mmahjoub5/tayloe-sdr/README.md

# tayloe-sdr
Custom Hardware &amp; SDR with ownership of entire stack

# credits
https://github.com/darius3241/Software-Defined-Radio
