mmahjoub5/tayloe-sdr/code/websdr/sdr/DOCKER.md

# WebSDR on the Pi with Docker

One image (`Dockerfile`), four services (`docker-compose.yml`: bridge, engine, ft8, server). No registry.

## Build on the Pi (from `code/` on the Mac)

The sources are a few MB; the Pi downloads GNU Radio itself (the first build takes a while, later ones reuse
the apt layer).

    COPYFILE_DISABLE=1 tar --exclude __pycache__ --exclude '*.egg-info' --exclude websdr/sdr/build \
        -cf - radiolib gnu-radio/iq_bridge.py websdr/sdr \
      | ssh pi@10.0.0.216 'rm -rf ~/websdr-src && mkdir ~/websdr-src && tar -xf - -C ~/websdr-src \
          && cp ~/websdr-src/websdr/sdr/docker-compose.yml ~/websdr/'
    ssh pi@10.0.0.216 'cd ~/websdr-src && docker build -f websdr/sdr/Dockerfile -t websdr:latest .'

Or build on the Mac (arm64 too, so no emulation) and copy the image; this needs several GB free on the Mac:

    docker buildx build --platform linux/arm64 -f websdr/sdr/Dockerfile -t websdr:latest --load .
    docker save websdr:latest | gzip | ssh pi@10.0.0.216 'gunzip | docker load'

## First time on the Pi

    sudo apt install docker.io docker-compose        # Docker 26, Compose 2.26 on trixie
    sudo usermod -aG docker pi                       # log out and back in
    sudo systemctl disable --now rp2040-rtltcp      # only one program can open the board
    mkdir -p ~/websdr && echo "SDR_KEY=memagic" > ~/websdr/.env

OpenWebRX keeps the RTL dongle; its "Tayloe board" device stops working while this runs.

## Run

    cd ~/websdr && docker compose up -d             # http://10.0.0.216:8090/#key=memagic
    docker compose logs -f engine                   # or bridge, server
    docker compose down

The code isn't baked into the image: compose mounts `~/websdr-src` (bridge script, `websdr/sdr/`) and the engine
compiles `engine.grc` when it starts (~10 s). So a code change is the `tar | ssh` copy above, then
`docker compose up -d --force-recreate engine ft8 server` (and `bridge` if `iq_bridge.py` changed); no `docker build`.
Rebuild the image only when packages, radiolib or the pinned ft8_lib commit change. Services restart on their own after a crash or a reboot.

Each engine start sends the board to 1.17 MHz for about 15 s: `grcc` creates the Board Tuner with its default
parameters while compiling, and those go out to the bridge until the running engine's tuner corrects them. The bridge exits if the board is unplugged and restarts until it's back;
the engine's Board Tuner repeats its frequency every 3 s, so the board comes back tuned.

Public access: point cloudflared at `http://localhost:8090`.
