mmahjoub5/tayloe-sdr/code/notes/am_fft.png

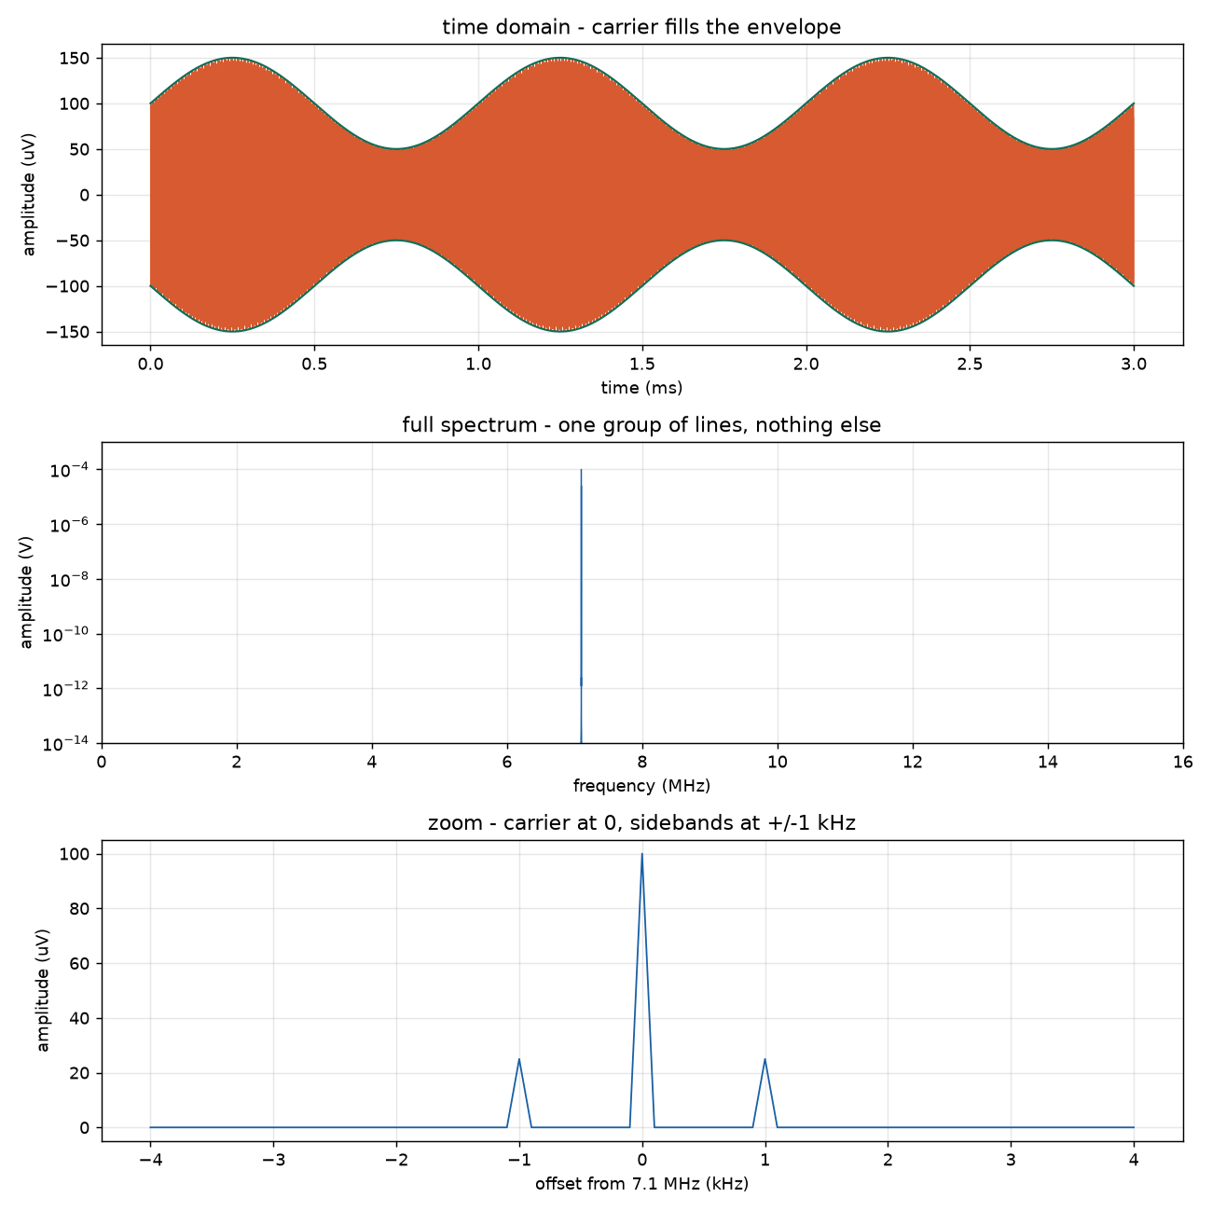
code/notes/am_fft.png
