mmahjoub5/tayloe-sdr/code/notes/am_textbook_style.png

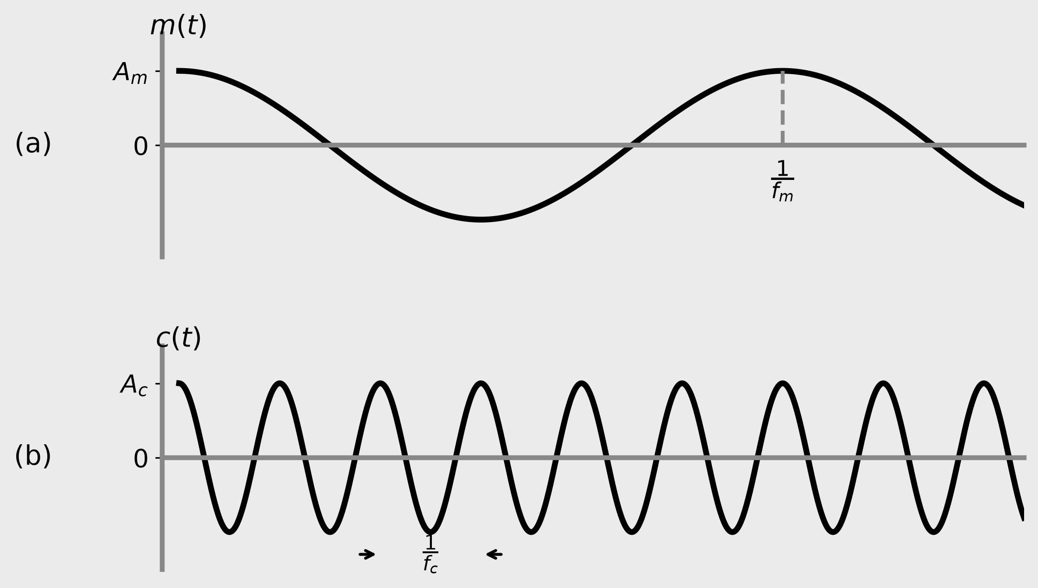
code/notes/am_textbook_style.png
