mmahjoub5/tayloe-sdr/meche/out/enclosure.FCStd

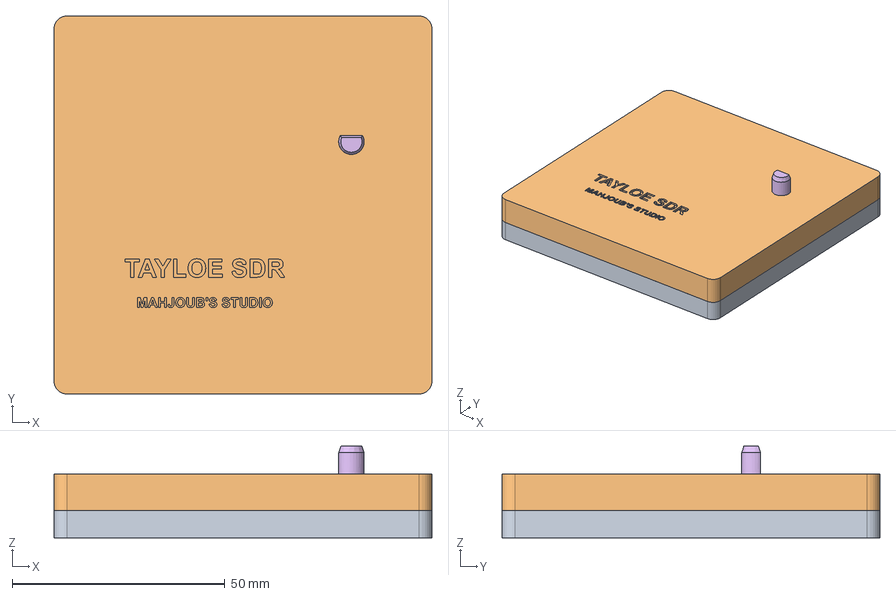
[picture p4: CAD file, 2026-10-29]
meche/out/enclosure.FCStd
88.8 x 88.8 x 21.5 mm
R_0402_1005Metric
C_0603_1608Metric
R_0402_1005Metric002
R_0402_1005Metric004
TSSOP-16_4.4x5mm_P0.65mm
C_0603_1608Metric002
C_0402_1005Metric
C_0603_1608Metric004
MSOP-8_3x3mm_P0.65mm
TSSOP-14_4.4x5mm_P0.65mm
R_0402_1005Metric006
C_0603_1608Metric006
R_0402_1005Metric008
R_0402_1005Metric010
R_0402_1005Metric012
L_0805_2012Metric
C_0402_1005Metric002
C_0603_1608Metric008
R_0402_1005Metric014
L_0603_1608Metric
R_0402_1005Metric016
SMA_Samtec_SMA-J-P-H-ST-EM1_EdgeMount
R_0402_1005Metric018
C_0603_1608Metric010
C_0805_2012Metric
C_0805_2012Metric002
L_0805_2012Metric002
MSOP-10_3x3mm_P0.5mm
C_0805_2012Metric004
R_0402_1005Metric020
C_0603_1608Metric012
R_0402_1005Metric022
R_0402_1005Metric024
C_0402_1005Metric004
C_0201_0603Metric
C_0402_1005Metric006
C_0603_1608Metric014
R_0402_1005Metric026
C_0603_1608Metric016
R_0402_1005Metric028
R_0402_1005Metric030
R_0402_1005Metric032
R_0402_1005Metric034
R_0402_1005Metric036
C_0603_1608Metric018
C_0603_1608Metric020
R_0402_1005Metric038
R_0402_1005Metric040
C_0201_0603Metric002
C_0402_1005Metric008
R_0402_1005Metric042
R_0402_1005Metric044
R_0402_1005Metric046
C_0402_1005Metric010
R_0402_1005Metric048
R_0402_1005Metric050
R_0402_1005Metric052
C_0805_2012Metric006
Crystal_SMD_3225-4Pin_3.2x2.5mm
R_0402_1005Metric054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
