mmahjoub5/tayloe-sdr/meche/out/print/lid.step

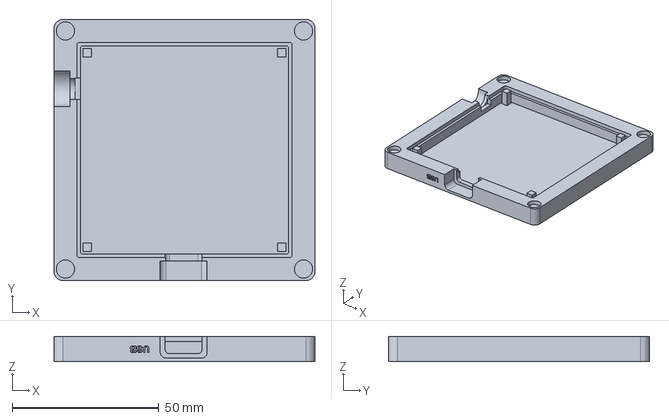
[picture p5: CAD file, 2026-10-29]
meche/out/print/lid.step
88.8 x 88.8 x 8.58 mm
