mmahjoub5/tayloe-sdr/meche/out/enclosure_base.step

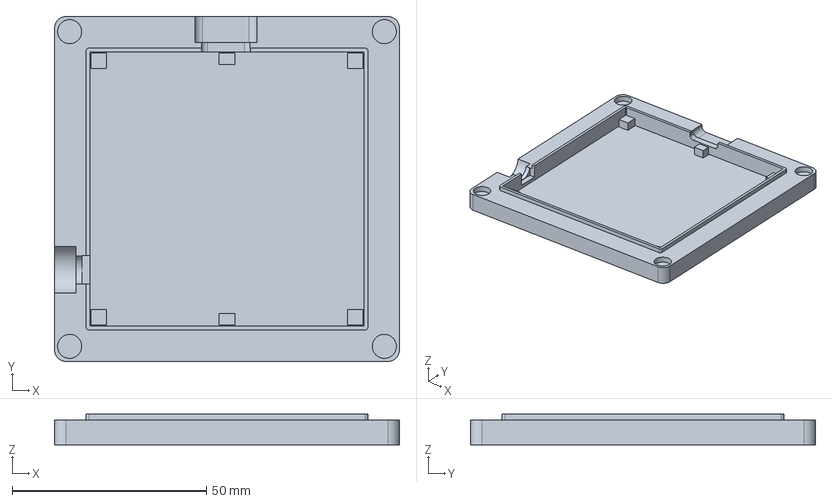
[picture p6: CAD file, 2026-10-29]
meche/out/enclosure_base.step
88.8 x 88.8 x 7.92 mm
