mmahjoub5/tayloe-sdr/(list of files, cad)

Other CAD files:
meche/radio.FCStd
meche/out/print/base.step
meche/out/enclosure_lid.step
meche/out/enclosure_base.stl
meche/out/enclosure_lid.stl
meche/out/print/base.3mf
meche/out/print/base.stl
meche/out/print/lid.3mf
meche/out/print/lid.stl
