mmahjoub5/tayloe-sdr/LTspice files/Mixer and amp model.asc

B2: bv; V={rf_amp}*(1+{mod_index}*sin(2*pi*{mod_freq}*time))*sin(2*pi*{RF_freq}*time)
C1: Cap; {sample_cap}
C2: Cap; {sample_cap}
C3: Cap; {sample_cap}
C4: Cap; {sample_cap}
C5: Cap; 100p
C6: Cap; 100p
C8: Cap; 100n
L1: ind; 560n
R1: Res; 1k
R2: Res; 1k
R3: Res; 31.6k
R4: res; 31.6k
R5: Res; 1k
R6: Res; 1k
R7: Res; 31.6k
R8: Res; 1k
R9: res; 31.6k
R14: Res; 50
S1: sw; MYSW
S2: sw; MYSW
S3: sw; MYSW
S4: sw; MYSW
U1: OPAx320-Q1
U2: OPAx320-Q1
V1: voltage; 1.65
V2: Voltage; 3.3
V7: voltage; PULSE(0 5 0 1n 1n {SW_time} {4*SW_time})
V8: voltage; PULSE(0 5 {SW_time} 1n 1n {SW_time} {4*SW_time})
V9: voltage; PULSE(0 5 {2*SW_time} 1n 1n {SW_time} {4*SW_time})
V10: voltage; PULSE(0 5 {3*SW_time} 1n 1n {SW_time} {4*SW_time})
Named nets: 0, V_0_deg, V_90_deg, V_180_deg, V_270_deg, 00, 11, 01, 10, V+, V-, I, Q, +3V3_ANALOG
.inc LM4562Fixed.LIB
.model MYSW SW(Vt=0.9 Vh=0 Ron=4 Roff=100G)
.tran 0 3m 500u 2n
;.ac dec 100 100k 100Meg
;.noise V(V_outQ) V3 dec 10 10 100meg
;.op
.param LO_freq={RF_freq} LO_period={1/LO_freq} SW_time={LO_period/4}
Signals for voltage-controlled switches 
used to simulate our multiplexer.
Multiplexer
Simulation Control
;step oct param Audio_freq 1000 10000 1
.param Audio_freq 0
RF signal in
BandPass Filter
.include OPAx320-Q1.lib
.param RF_freq = 7.100Meg
.param mod_freq = 1k
.param mod_index = 0.5
.param rf_amp = 100u
.meas tran idc AVG V(I) FROM 0.8m TO 1.2m
V={rf_amp}*(1+{mod_index}*sin(2*pi*{mod_freq}*time))*sin(2*pi*{RF_freq}*time)
.param sample_cap 100n
.options plotwinsize=0 numdgt=7 reltol=1e-5 vntol=1e-9 abstol=1e-13 trtol=1
AM Signal
DSB Signal
V={rf_amp}*sin(2*pi*{RF_freq}*time)*sin(2*pi*{mod_freq}*time)
.param mod_amp 1
SSB Signal
V={rf_amp}*sin(2*pi*({RF_freq}+{mod_freq})*time)
