mmahjoub5/tayloe-sdr/radio-project/radio-project.kicad_pcb

## KiCad design radio-project/radio-project.kicad_pcb (2026-10-29)

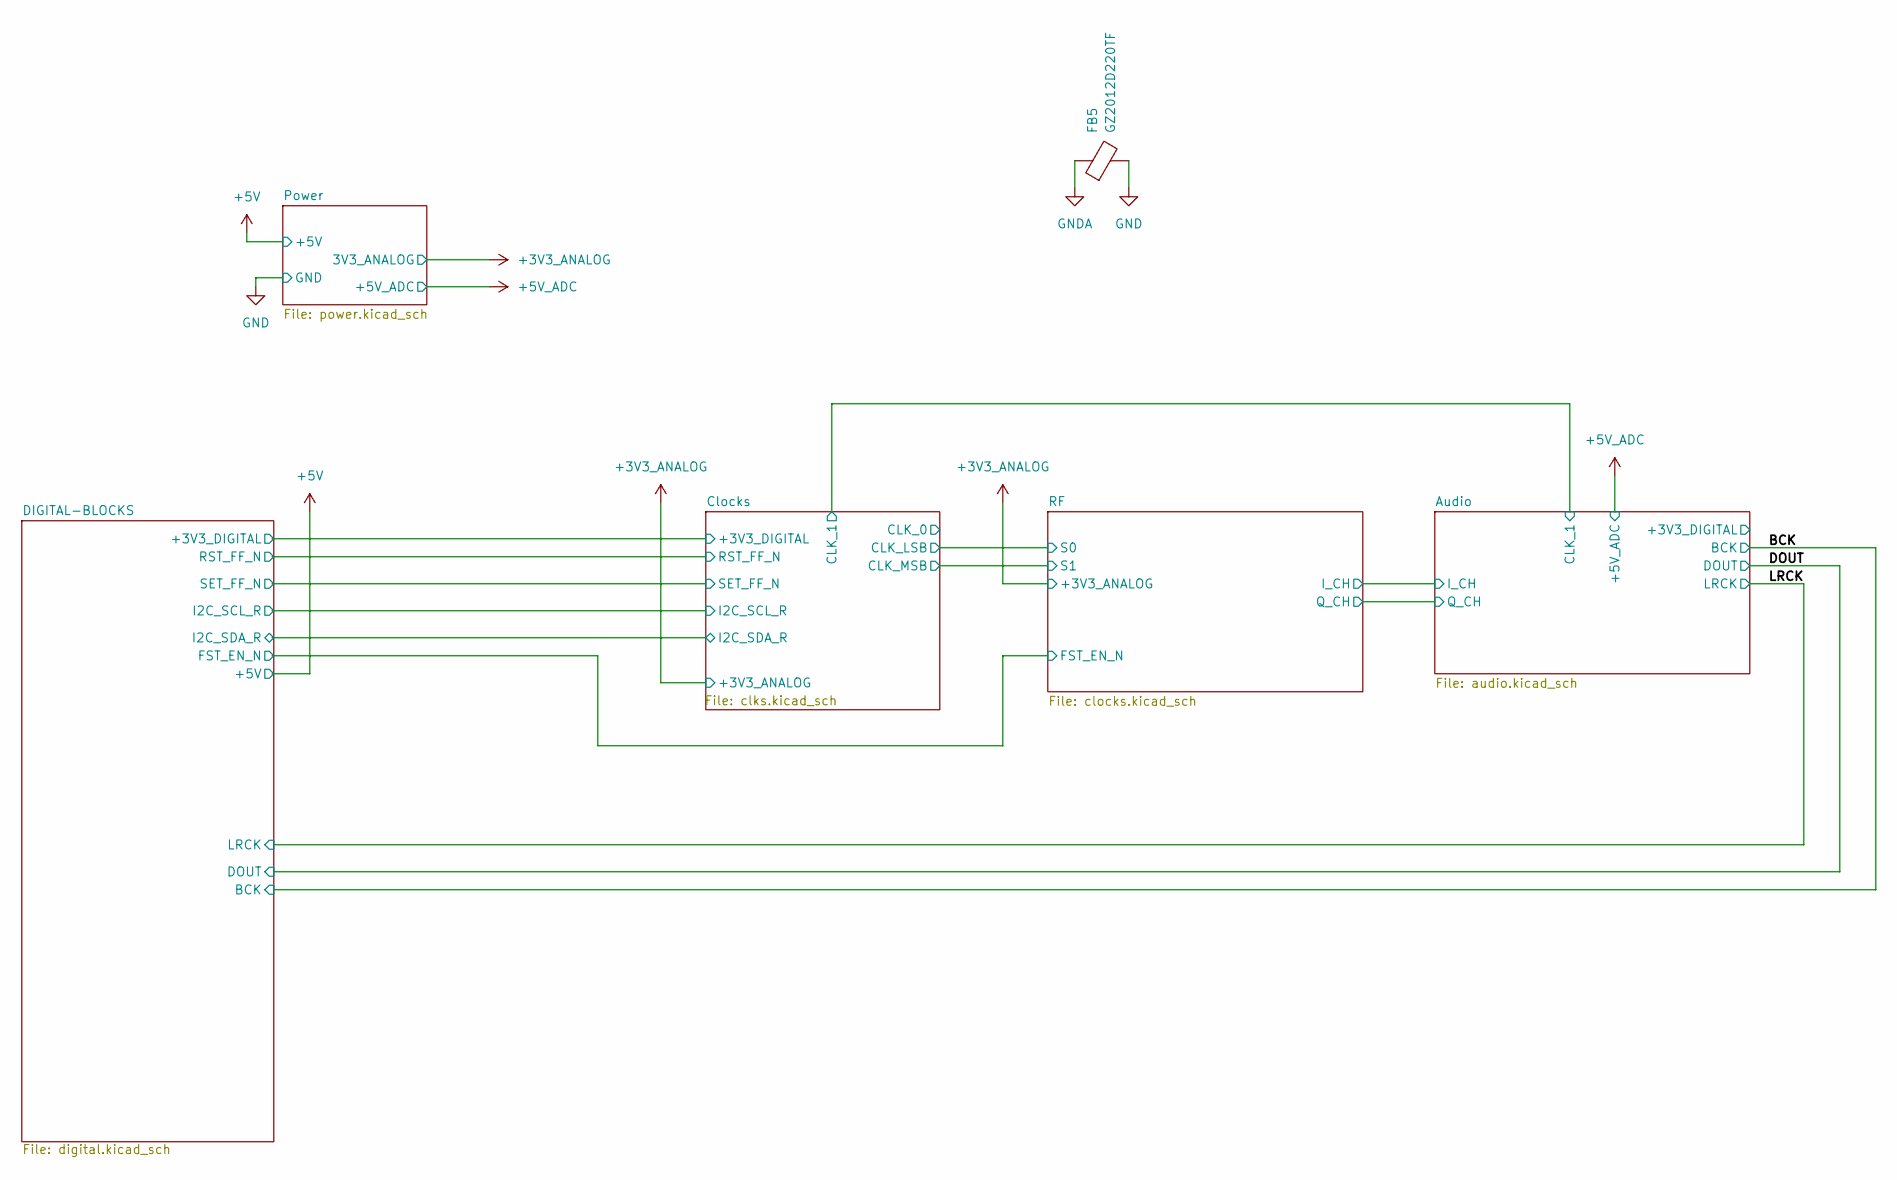
[picture p13: schematic radio-project.kicad_sch]

Parts:
FB5: GZ2012D220TF; L_0805_2012Metric

Connections:
GND: FB5.2; also elsewhere on the board
GNDA: FB5.1; also elsewhere on the board

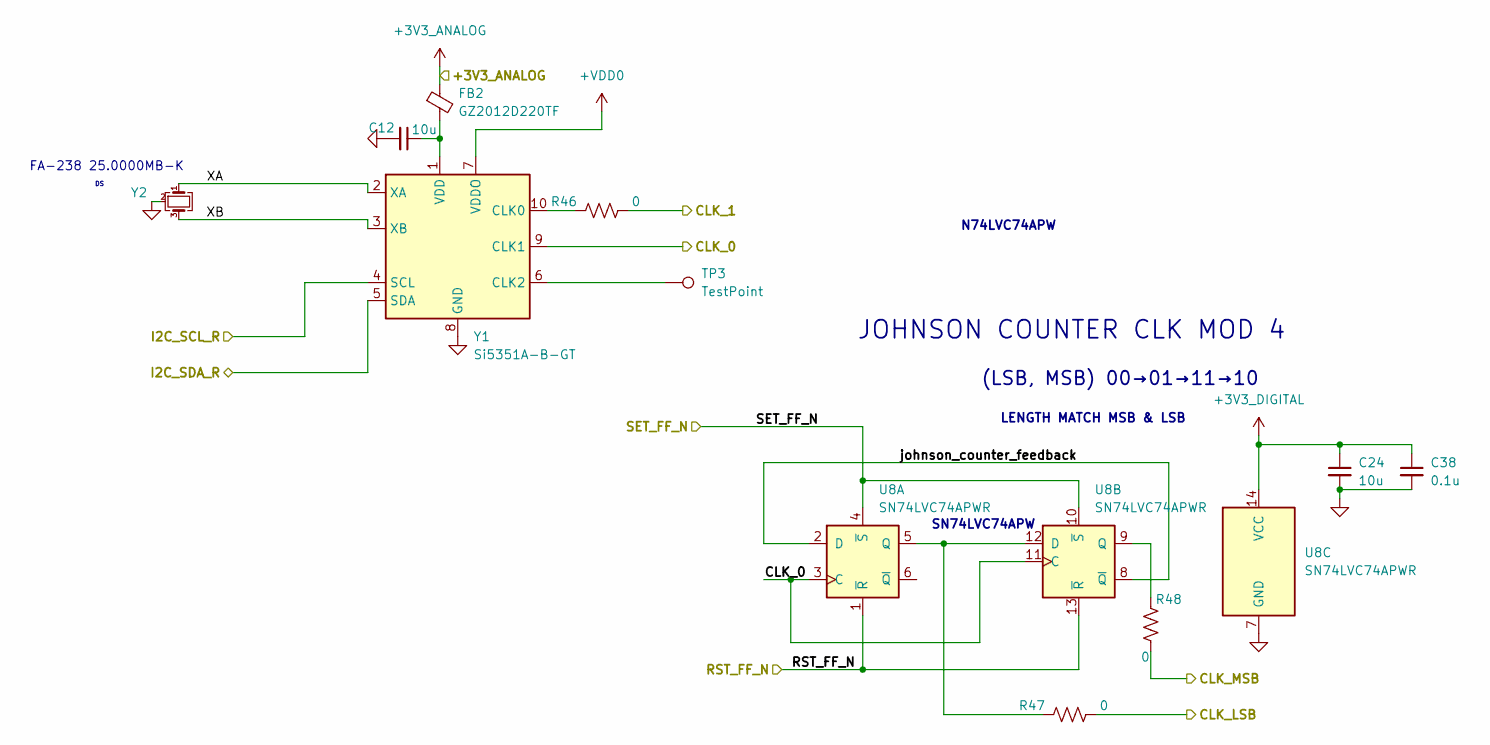
[picture p14: schematic clks.kicad_sch]

Parts:
C12, C24: 10u; C_0603_1608Metric
C38: 0.1u; C_0201_0603Metric
FB2: GZ2012D220TF; L_0805_2012Metric
R46, R47, R48: 0; R_0402_1005Metric
TP3: TestPoint; TestPoint_Pad_D1.0mm
U8: SN74LVC74APWR; TSSOP-14_4.4x5mm_P0.65mm
Y1: Si5351A-B-GT; MSOP-10_3x3mm_P0.5mm
Y2: 25Mhz; Crystal_SMD_3225-4Pin_3.2x2.5mm

Connections:
+3V3_ANALOG: FB2.1; also elsewhere on the board
+3V3_DIGITAL: C24.1, C38.1, U8.14 (VCC); also elsewhere on the board
+VDD0: Y1.7 (VDDO)
/Audio/CLK_1: R46.2; also elsewhere on the board
/Clocks/CLK_0: U8.3 (C), U8.11 (C), Y1.9 (CLK1)
/Clocks/CLK_LSB: R47.2; also elsewhere on the board
/Clocks/CLK_MSB: R48.2; also elsewhere on the board
/Clocks/I2C_SCL_R: Y1.4 (SCL); also elsewhere on the board
/Clocks/I2C_SDA_R: Y1.5 (SDA); also elsewhere on the board
/Clocks/RST_FF_N: U8.1 (~R), U8.13 (~R); also elsewhere on the board
/Clocks/SET_FF_N: U8.4 (~S), U8.10 (~S); also elsewhere on the board
/Clocks/XA: Y1.2 (XA), Y2.1
/Clocks/XB: Y1.3 (XB), Y2.3
/Clocks/johnson_counter_feedback: U8.2 (D), U8.8 (~Q)
GND: C12.2, C24.2, C38.2, U8.7 (GND), Y1.8 (GND), Y2.2 (G), Y2.4 (G); also elsewhere on the board
unnamed: R47.1, U8.5 (Q), U8.12 (D)
unnamed: R48.1, U8.9 (Q)
unnamed: R46.1, Y1.10 (CLK0)
unnamed: TP3.1 (1_1), Y1.6 (CLK2)
unnamed: C12.1, FB2.2, Y1.1 (VDD)

Notes on the sheet:
N74LVC74APW
JOHNSON COUNTER CLK MOD 4
FA-238 25.0000MB-K
SN74LVC74APW
(LSB, MSB) 00→01→11→10
LENGTH MATCH MSB & LSB

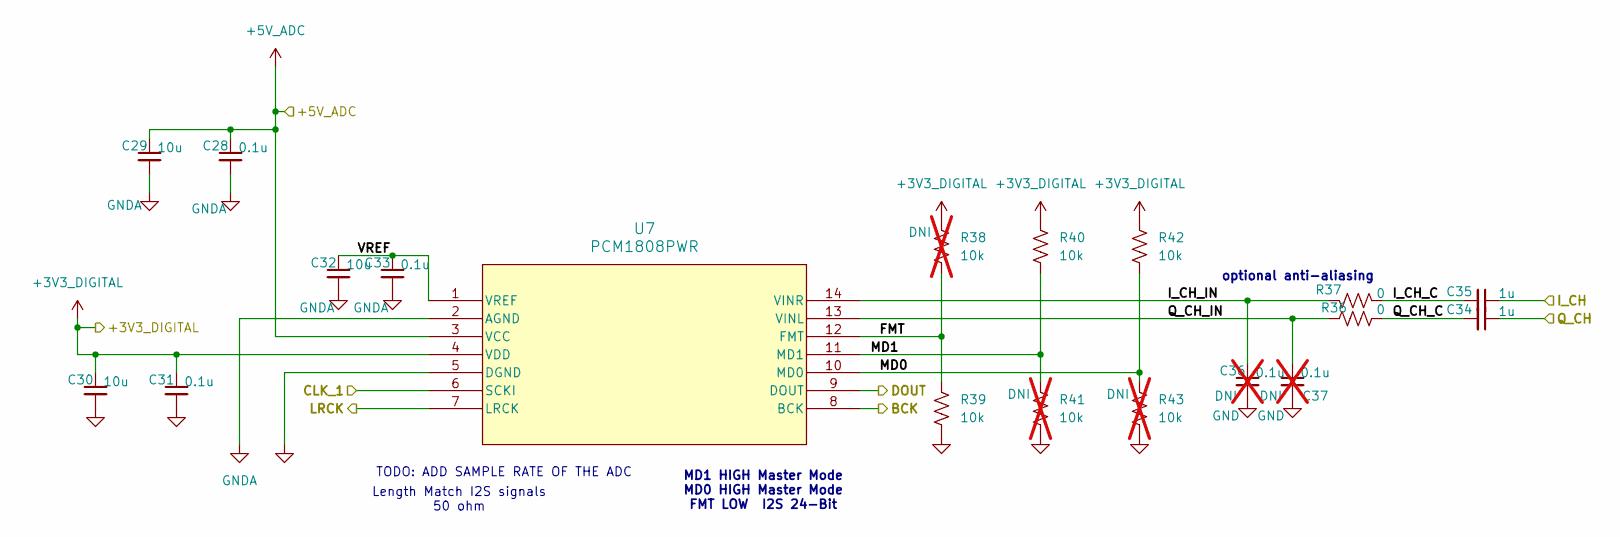
[picture p15: schematic audio.kicad_sch]

Parts:
C28, C31: 0.1u; C_0603_1608Metric
C29, C30, C32: 10u; C_0603_1608Metric
C33: 0.1u; C_0402_1005Metric
C34, C35: 1u; C_0402_1005Metric
C36, C37: 0.1u; C_0402_1005Metric; not fitted
R36, R37: 0; R_0402_1005Metric
R38, R41, R43: 10k; R_0402_1005Metric; not fitted
R39, R40, R42: 10k; R_0402_1005Metric
U7: PCM1808PWR; TSSOP-14_4.4x5mm_P0.65mm

Connections:
+3V3_DIGITAL: C30.1, C31.1, R38.1, R40.1, R42.1, U7.4 (VDD); also elsewhere on the board
+5V_ADC: C28.1, C29.1, U7.3 (VCC); also elsewhere on the board
/Audio/CLK_1: U7.6 (SCKI); also elsewhere on the board
/Audio/FMT: R38.2, R39.1, U7.12 (FMT)
/Audio/I_CH: C35.1; also elsewhere on the board
/Audio/I_CH_C: C35.2, R37.2
/Audio/I_CH_IN: C36.1, R37.1, U7.14 (VINR)
/Audio/MD0: R42.2, R43.1, U7.10 (MD0)
/Audio/MD1: R40.2, R41.1, U7.11 (MD1)
/Audio/Q_CH: C34.1; also elsewhere on the board
/Audio/Q_CH_C: C34.2, R36.2
/Audio/Q_CH_IN: C37.1, R36.1, U7.13 (VINL)
/Audio/VREF: C32.1, C33.1, U7.1 (VREF)
/BCK: U7.8 (BCK); also elsewhere on the board
/DOUT: U7.9 (DOUT); also elsewhere on the board
/LRCK: U7.7 (LRCK); also elsewhere on the board
GND: C30.2, C31.2, C36.2, C37.2, R39.2, R41.2, R43.2, U7.5 (DGND); also elsewhere on the board
GNDA: C28.2, C29.2, C32.2, C33.2, U7.2 (AGND); also elsewhere on the board

Notes on the sheet:
MD1 HIGH Master Mode MD0 HIGH Master Mode FMT LOW I2S 24-Bit
optional anti-aliasing
Length Match I2S signals 50 ohm
TODO: ADD SAMPLE RATE OF THE ADC

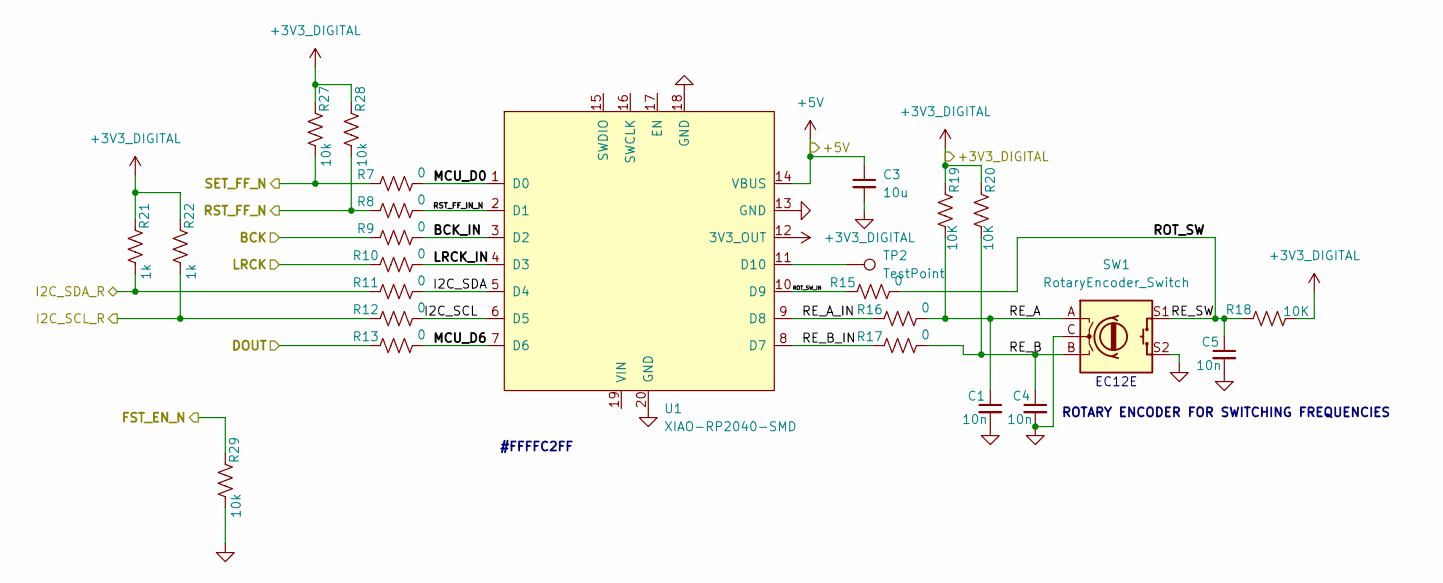
[picture p16: schematic digital.kicad_sch]

Parts:
C1, C4, C5: 10n; C_0402_1005Metric
C3: 10u; C_0603_1608Metric
R7, R8, R9, R10, R11, R12, R13, R15, R16, R17: 0; R_0402_1005Metric
R18, R19, R20: 10K; R_0402_1005Metric
R21, R22: 1k; R_0402_1005Metric
R27, R28, R29: 10k; R_0402_1005Metric
SW1: RotaryEncoder_Switch; RotaryEncoder_Alps_EC12E-Switch_Vertical_H20mm
TP2: TestPoint; TestPoint_Pad_D2.0mm
U1: XIAO-RP2040-SMD

Connections:
+3V3_DIGITAL: R18.1, R19.2, R20.2, R21.2, R22.2, R27.2, R28.2, U1.12 (3V3_OUT); also elsewhere on the board
+5V: C3.1, U1.14 (VBUS); also elsewhere on the board
/BCK: R9.2; also elsewhere on the board
/Clocks/I2C_SCL_R: R12.2, R22.1; also elsewhere on the board
/Clocks/I2C_SDA_R: R11.2, R21.1; also elsewhere on the board
/Clocks/RST_FF_N: R8.2, R28.1; also elsewhere on the board
/Clocks/SET_FF_N: R7.2, R27.1; also elsewhere on the board
/DIGITAL-BLOCKS/BCK_IN: R9.1, U1.3 (D2)
/DIGITAL-BLOCKS/I2C_SCL: R12.1, U1.6 (D5)
/DIGITAL-BLOCKS/I2C_SDA: R11.1, U1.5 (D4)
/DIGITAL-BLOCKS/LRCK_IN: R10.1, U1.4 (D3)
/DIGITAL-BLOCKS/MCU_D0: R7.1, U1.1 (D0)
/DIGITAL-BLOCKS/MCU_D6: R13.1, U1.7 (D6)
/DIGITAL-BLOCKS/RE_A: C1.1, R16.1, R19.1, SW1.A
/DIGITAL-BLOCKS/RE_A_IN: R16.2, U1.9 (D8)
/DIGITAL-BLOCKS/RE_B: C4.1, R17.1, R20.1, SW1.B
/DIGITAL-BLOCKS/RE_B_IN: R17.2, U1.8 (D7)
/DIGITAL-BLOCKS/RE_SW: C5.1, R15.1, R18.2, SW1.S1
/DIGITAL-BLOCKS/ROT_SW_IN: R15.2, U1.10 (D9)
/DIGITAL-BLOCKS/RST_FF_IN_N: R8.1, U1.2 (D1)
/DOUT: R13.2; also elsewhere on the board
/LRCK: R10.2; also elsewhere on the board
/RF/FST_EN_N: R29.2; also elsewhere on the board
GND: C1.2, C3.2, C4.2, C5.2, R29.1, SW1.C, SW1.S2, U1.13 (GND), U1.18 (GND), U1.20 (GND); also elsewhere on the board
unnamed: TP2.1 (1_1), U1.11 (D10)

Notes on the sheet:
EC12E
ROTARY ENCODER FOR SWITCHING FREQUENCIES
#FFFFC2FF

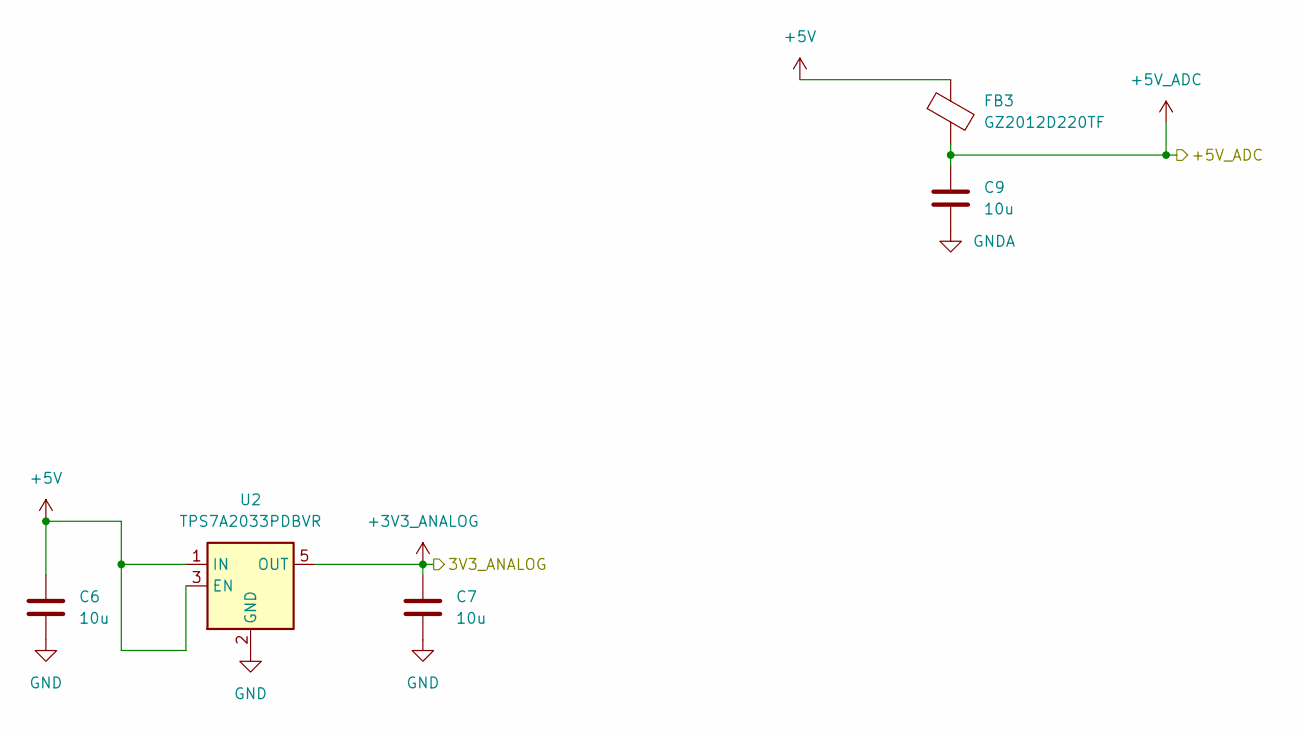
[picture p17: schematic power.kicad_sch]

Parts:
C6, C7, C9: 10u; C_0603_1608Metric_Pad1.08x0.95mm_HandSolder
FB3: GZ2012D220TF; L_0805_2012Metric
U2: TPS7A2033PDBVR; SOT-23-5

Connections:
+3V3_ANALOG: C7.1, U2.5 (OUT); also elsewhere on the board
+5V: C6.1, FB3.1, U2.1 (IN), U2.3 (EN); also elsewhere on the board
+5V_ADC: C9.1, FB3.2; also elsewhere on the board
GND: C6.2, C7.2, U2.2 (GND); also elsewhere on the board
GNDA: C9.2; also elsewhere on the board

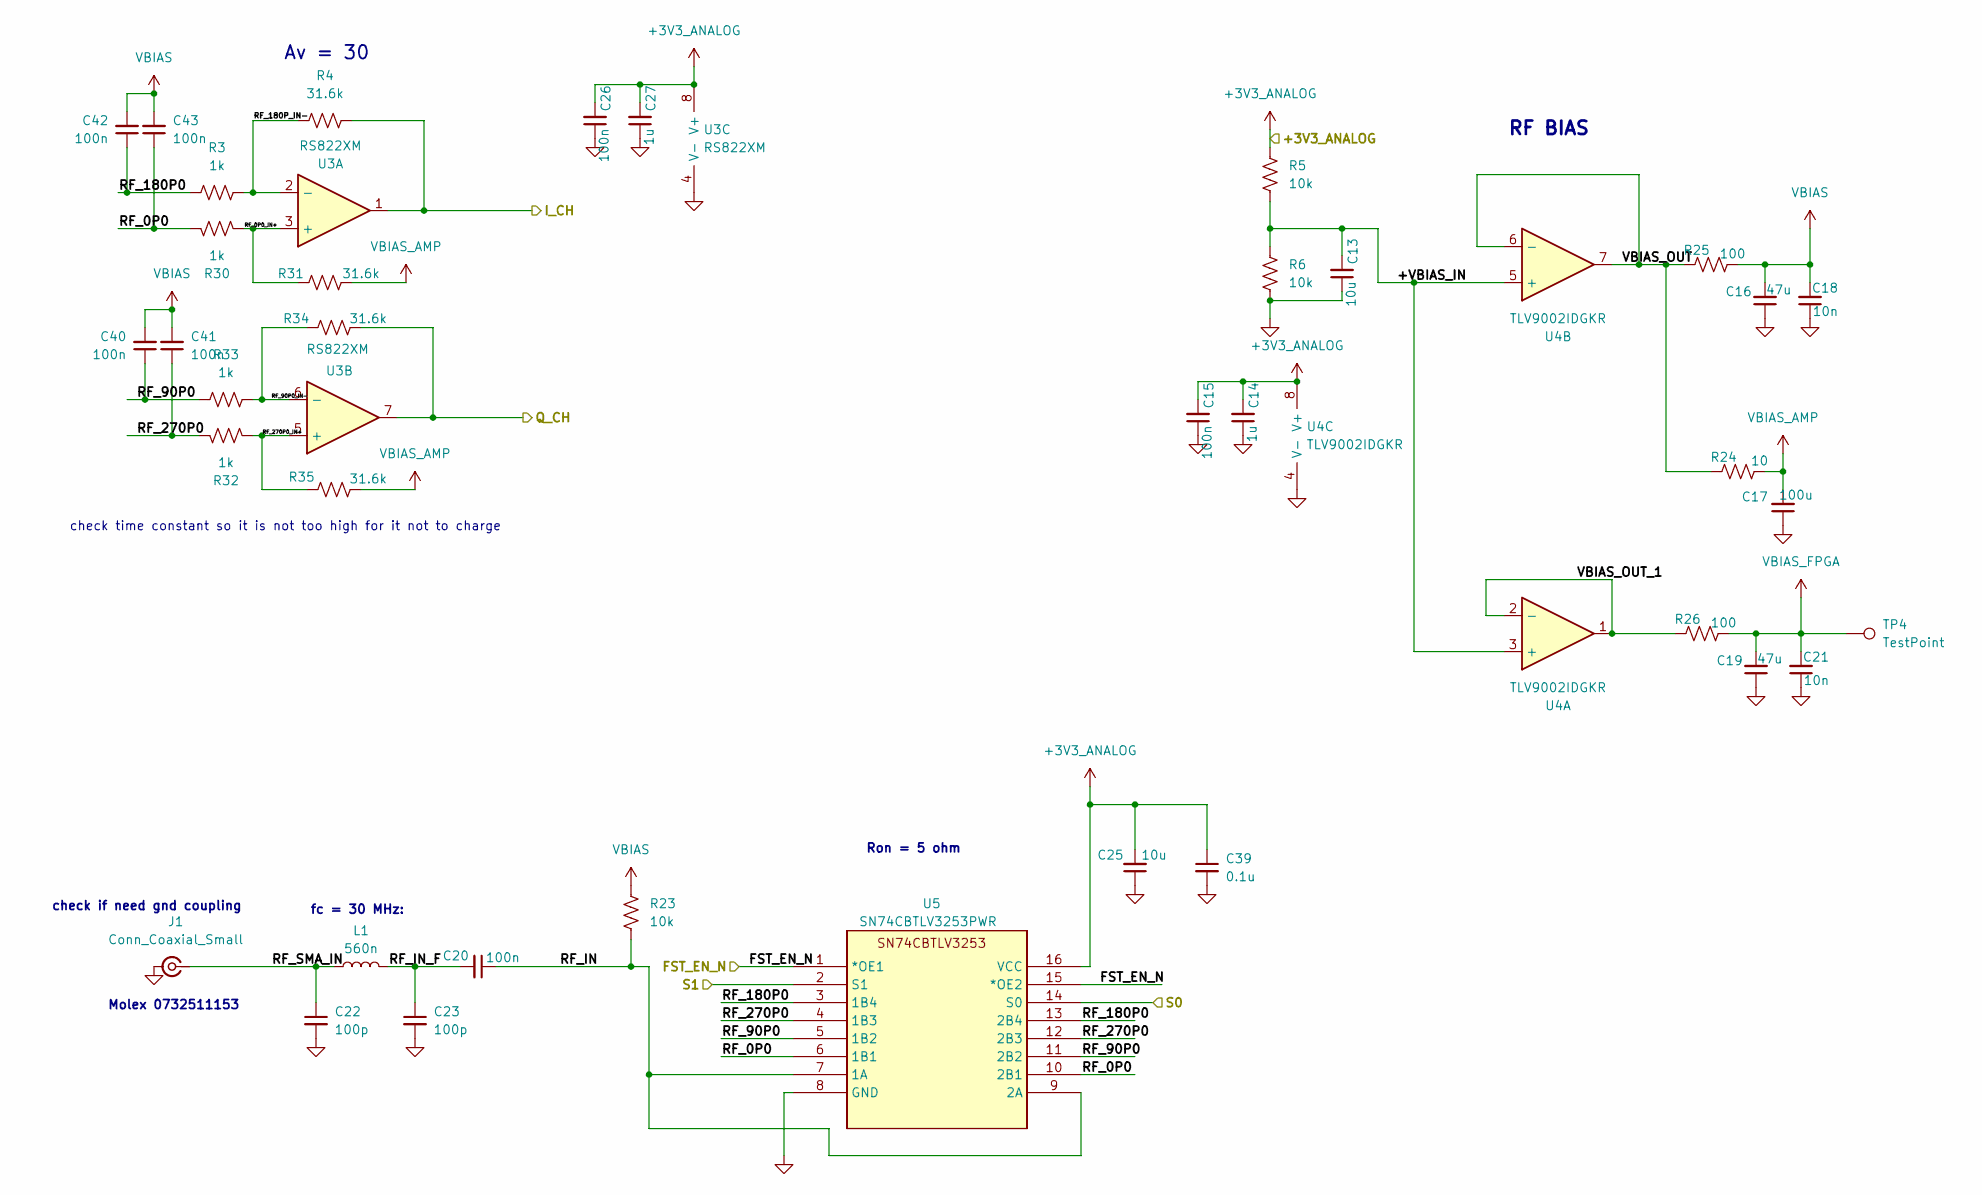
[picture p18: schematic clocks.kicad_sch]

Parts:
C13, C25: 10u; C_0603_1608Metric
C14, C27: 1u; C_0603_1608Metric
C15, C20, C26: 100n; C_0402_1005Metric
C16, C19: 47u; C_0805_2012Metric
C17: 100u; C_0805_2012Metric
C18, C21: 10n; C_0402_1005Metric
C22, C23: 100p; C_0402_1005Metric
C39: 0.1u; C_0201_0603Metric
C40, C41, C42, C43: 100n; C_0805_2012Metric
J1: Conn_Coaxial_Small; SMA_Samtec_SMA-J-P-H-ST-EM1_EdgeMount
L1: 560n; L_0603_1608Metric
R3, R30, R32, R33: 1k; R_0402_1005Metric
R4, R31, R34, R35: 31.6k; R_0402_1005Metric
R5, R6, R23: 10k; R_0402_1005Metric
R24: 10; R_0402_1005Metric
R25, R26: 100; R_0402_1005Metric
TP4: TestPoint; TestPoint_Pad_D2.0mm
U3: RS822XM; MSOP-8_3x3mm_P0.65mm
U4: TLV9002IDGKR; MSOP-8_3x3mm_P0.65mm
U5: SN74CBTLV3253PWR

Connections:
+3V3_ANALOG: C14.2, C15.2, C25.2, C26.2, C27.2, C39.1, R5.1, U3.8 (V+), U4.8 (V+), U5.16 (VCC); also elsewhere on the board
/Audio/I_CH: R4.2, U3.1; also elsewhere on the board
/Audio/Q_CH: R34.2, U3.7; also elsewhere on the board
/Clocks/CLK_LSB: U5.14 (S0); also elsewhere on the board
/Clocks/CLK_MSB: U5.2 (S1); also elsewhere on the board
/RF/+VBIAS_IN: C13.2, R5.2, R6.1, U4.3 (+), U4.5 (+)
/RF/FST_EN_N: U5.1 (*OE1), U5.15 (*OE2); also elsewhere on the board
/RF/RF_0P0: C43.1, R30.1, U5.6 (1B1), U5.10 (2B1)
/RF/RF_0P0_IN+: R30.2, R31.1, U3.3 (+)
/RF/RF_90P0: C40.1, R33.1, U5.5 (1B2), U5.11 (2B2)
/RF/RF_90P0_IN-: R33.2, R34.1, U3.6 (-)
/RF/RF_180P0: C42.1, R3.1, U5.3 (1B4), U5.13 (2B4)
/RF/RF_180P_IN-: R3.2, R4.1, U3.2 (-)
/RF/RF_270P0: C41.1, R32.1, U5.4 (1B3), U5.12 (2B3)
/RF/RF_270P0_IN+: R32.2, R35.1, U3.5 (+)
/RF/RF_IN: C20.1, R23.2, U5.7 (1A), U5.9 (2A)
/RF/RF_IN_F: C20.2, C23.1, L1.2
/RF/RF_SMA_IN: C22.1, J1.1 (In), L1.1
/RF/VBIAS_OUT: R24.1, R25.1, U4.6 (-), U4.7
/RF/VBIAS_OUT_1: R26.1, U4.1, U4.2 (-)
GND: C13.1, C14.1, C15.1, C16.1, C17.1, C18.1, C19.1, C21.1, C22.2, C23.2, C25.1, C26.1, C27.1, C39.2, J1.2 (Ext), R6.2, U3.4 (V-), U4.4 (V-), U5.8 (GND); also elsewhere on the board
VBIAS: C16.2, C18.2, C40.2, C41.2, C42.2, C43.2, R23.1, R25.2
VBIAS_AMP: C17.2, R24.2, R31.2, R35.2
VBIAS_FPGA: C19.2, C21.2, R26.2, TP4.1 (1_1)

Notes on the sheet:
Av = 30
check if need gnd coupling
RF BIAS
Molex 0732511153
check time constant so it is not too high for it not to charge
fc = 30 MHz:
Ron = 5 ohm

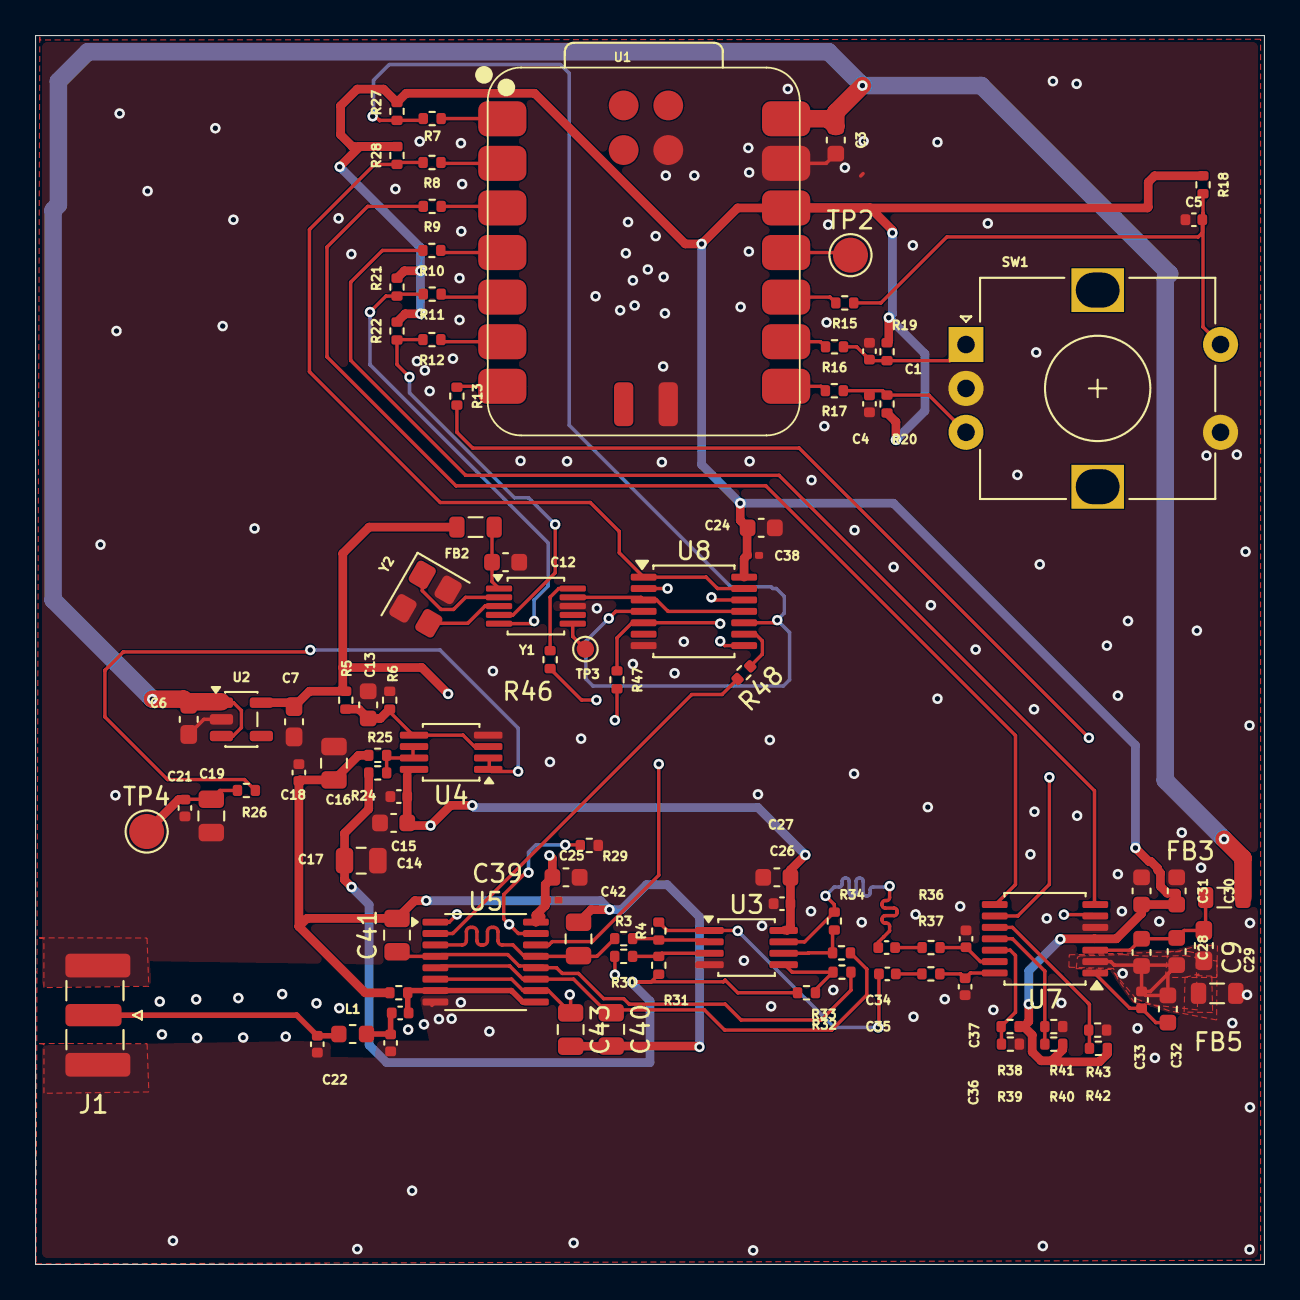
[picture p19: board radio-project.kicad_pcb from above]

Board: 4 copper layers, 70.0 x 70.0 mm, 100 parts (0 on the bottom side), 67 nets.
