mmahjoub5/tayloe-sdr/(commit log)

2026-09-14 initial commit one channel only working on radio, gnu am radio set,
    [audio.kicad_sch, clks.kicad_sch, clocks.kicad_sch, digital.kicad_sch, page_1.kicad_sch, power.kicad_sch, radio-project.kicad_pcb, radio-project.kicad_sch]
2026-10-29 Tayloe board in OpenWebRX, firmware stream decim, repo cleanup
    - websdr/rp2040_rtltcp_bridge.py + rp2040-rtltcp.service: serve the RP2040
    board as an rtl_tcp server so OpenWebRX on the Pi can use it (24 kHz)
    - radio_cli: `adc stream [secs] [decim]`, decim 1 = 48 kHz, 2 = 24 kHz
    - radiolib: find the board by USB ID (find_port), RadioBoard(decim=...)
    - radiolib ft8 package, dsp package, tests, gnu-radio scripts, apps, bench
    - CLAUDE.md docs for the board, bridge, Pi setup and TODOs
    - removes old sigproc/ and gnu-radio AM/FM experiments; adds meche/ enclosure
    and KiCad updates
    [audio.kicad_sch, base.3mf, base.step, base.stl, enclosure.FCStd, enclosure_base.step, enclosure_base.stl, enclosure_lid.step]
2026-11-06 Websdr server (#3)
    * Own WebSDR for the Tayloe board, grc-maker skill
    websdr/sdr/: a web SDR that replaces OpenWebRX for the board.
    - engine.grc: headless GNU Radio flowgraph. Waterfall plus AM and SSB
    phasing (USB and LSB via a sideband sign), controls over XML-RPC,
    outputs over ZMQ.
    - server.py: FastAPI relay to browsers over one WebSocket, key check,
    /api/diag from diag.py (CPU, memory, temperature, throttling, Wi-Fi,
    processes).
    - static/: radio page and diagnostics page. fake_engine.py stands in
    for the engine. run.sh runs it all on the Mac.
    - Dockerfile + docker-compose.yml for the Pi (bridge, engine, server),
    PROTOCOL.md and DOCKER.md.
    GNU Radio:
    - The Board Tuner re-sen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
    [rp2040_rtltcp_bridge.py]
2026-11-06 Firmware: buffered 24-bit ADC stream, adc stats, bootsel (#4)
    The board lost a few ADC samples every 1024 frames on the Pi:
    Serial.write blocked whenever the zero-margin USB link fell behind, and
    the PIO FIFO overflowed. Every signal got a 23.4 Hz comb (-28 dBc around
    the AM 1170 carrier) and audio ran 0.4 % short.
    - radio_cli: adc stream drains the ADC into a 30 KB ring and writes to
    USB only what it has room for. `adc stream secs decim 24` sends packed
    24-bit frames (6 B, 144 KB/s at 24 kHz, headroom on the Pi). `adc
    stats` reports frames produced and overruns. `bootsel` reboots into
    the UF2 bootloader for remote flashing.
    - radiolib: stream() asks for 24-bit and reads the format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
    [audio_adc.cpp, audio_adc.h, board.py, commands.cpp, hardware.py, test_board.py]
2026-11-09 WebSDR: FT8 decoding with ft8_lib (#5)
    * WebSDR: decode FT8 with ft8_lib and show it on the page
    radiolib's decoder took 36-38 s per slot on the Pi, too slow for a 15 s
    slot. ft8_lib's decode_ft8 takes about 0.2 s and already prints message
    text, so it runs as a subprocess in its own container.
    - engine.grc: the resampler now sits before the volume and also feeds
    an FT8 audio output on :5562, unaffected by the volume.
    - ft8_service.py: at each UTC slot, decodes the last 15 s if the radio
    stayed in USB on an FT8 frequency, and publishes the messages on :5563.
    - server.py: relays decoded slots and replays the last 40 to new pages.
    - Page: an FT8 table with a Clear button for this browser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
2026-11-09 TODO: waterproof enclosure next rev; note the CAD session in README
2026-11-09 CLAUDE.md: enclosure CAD notes and the upstream remote; ignore .claude.local.md
2026-11-09 meche: README for the radio + Pi 3 B+ enclosure (#7)
2026-11-09 meche: README for the radio + Pi 3 B+ enclosure, built with the FreeCAD MCP
